pabender/HotBoxDetectorSimulator/images/IMGP5215.JPG

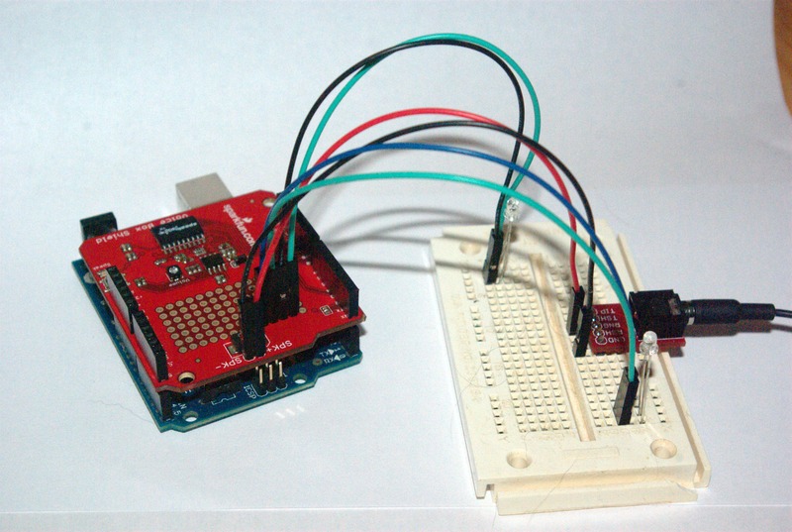
images/IMGP5215.JPG
