pabender/HotBoxDetectorSimulator/images/IMGP5261.JPG

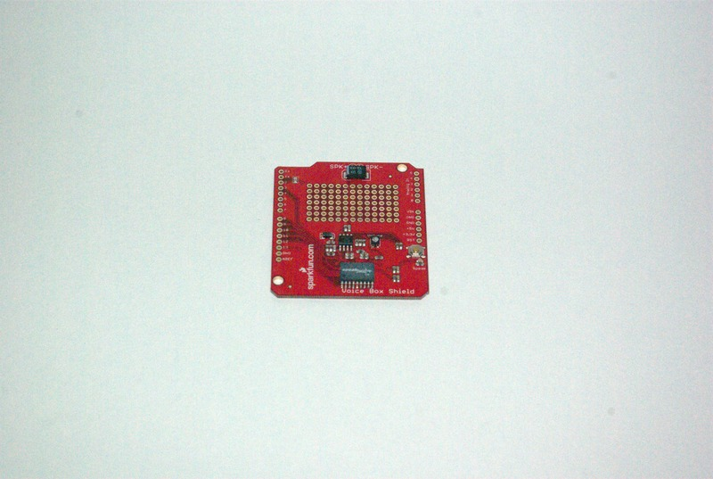
images/IMGP5261.JPG
