pabender/HotBoxDetectorSimulator/images/IMGP5262.JPG

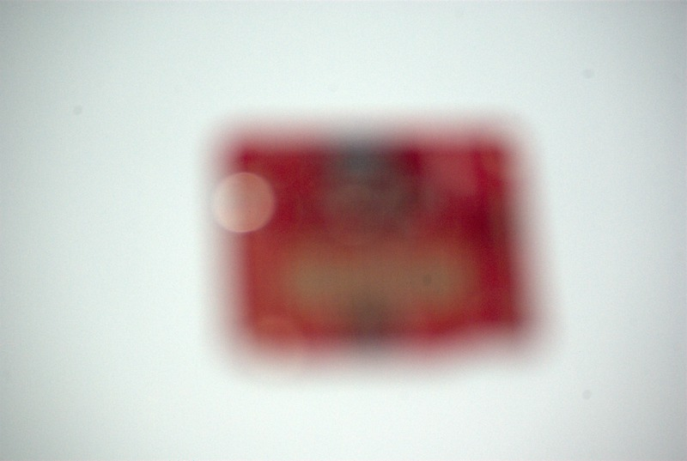
images/IMGP5262.JPG
