pabender/HotBoxDetectorSimulator/images/IMGP5263.JPG

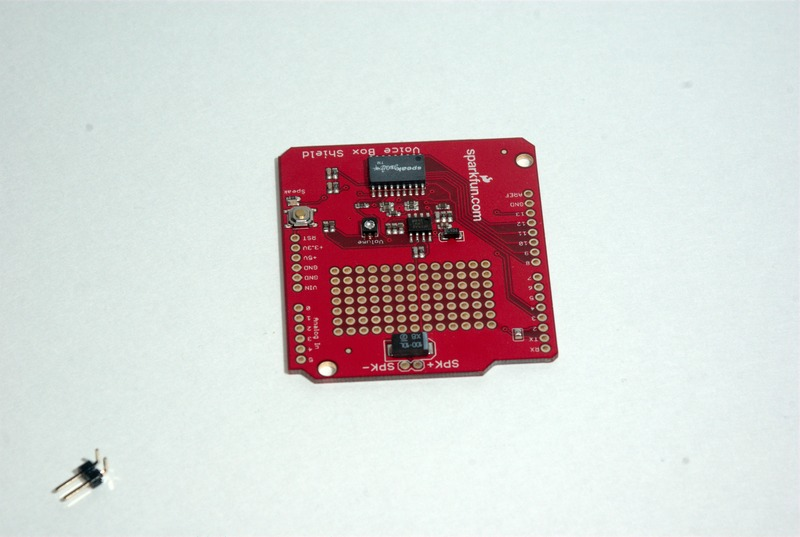
images/IMGP5263.JPG
