pabender/HotBoxDetectorSimulator/images/IMGP5265.JPG

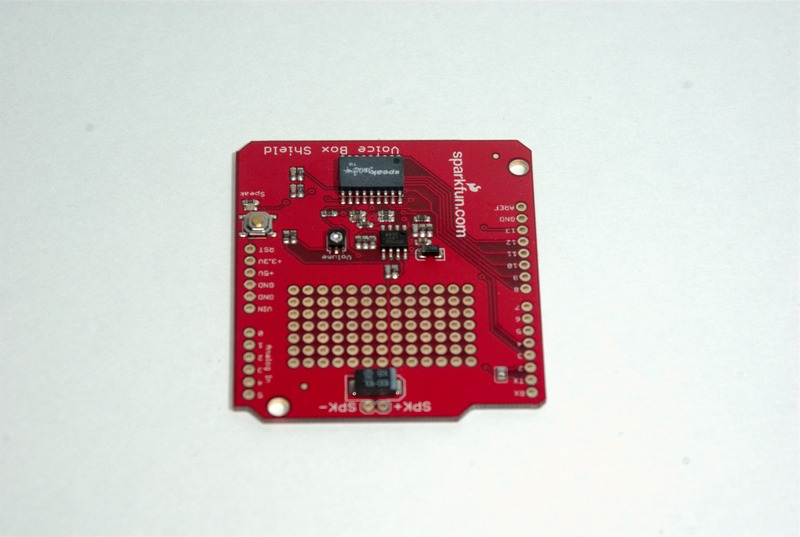
images/IMGP5265.JPG
