pabender/HotBoxDetectorSimulator/images/IMGP5266.JPG

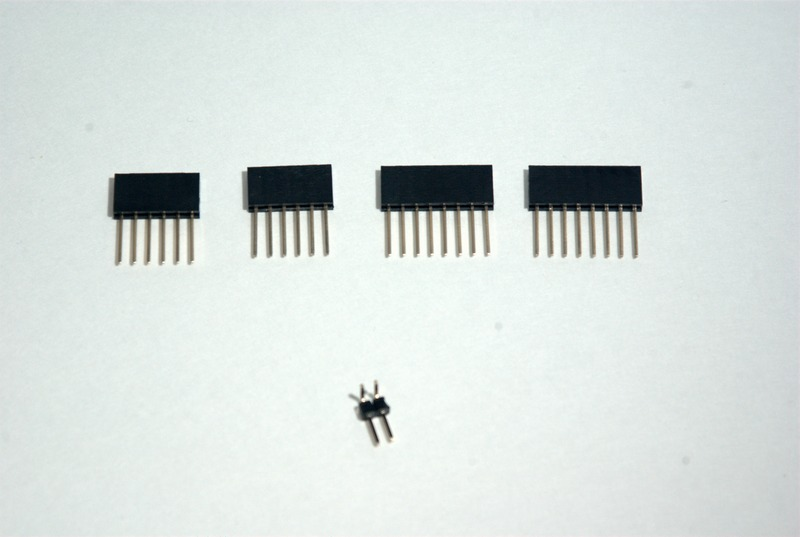
images/IMGP5266.JPG
