pabender/HotBoxDetectorSimulator/images/IMGP5267.JPG

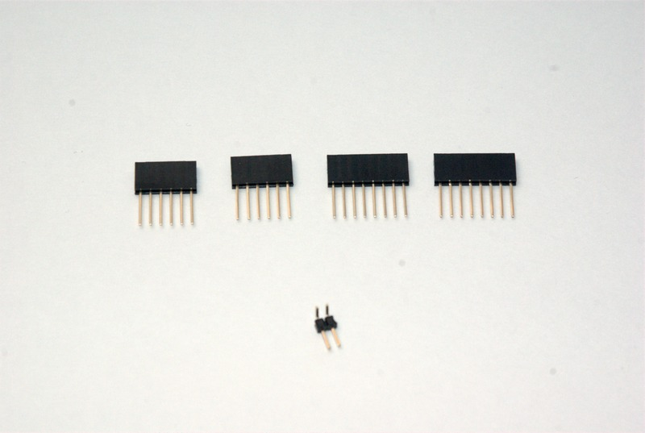
images/IMGP5267.JPG
