pabender/HotBoxDetectorSimulator/images/IMGP5269.JPG

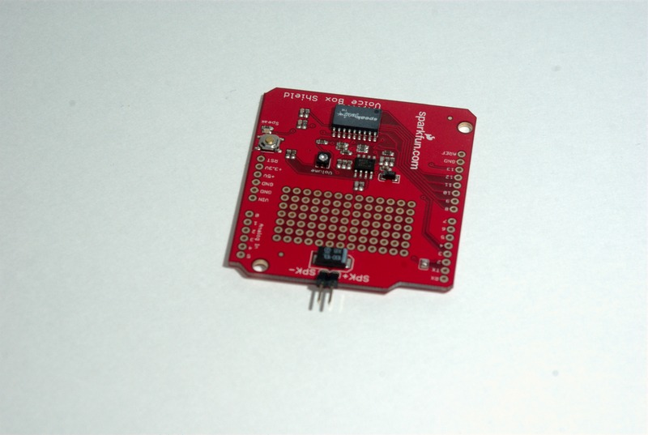
images/IMGP5269.JPG
