pabender/HotBoxDetectorSimulator/images/IMGP5270.JPG

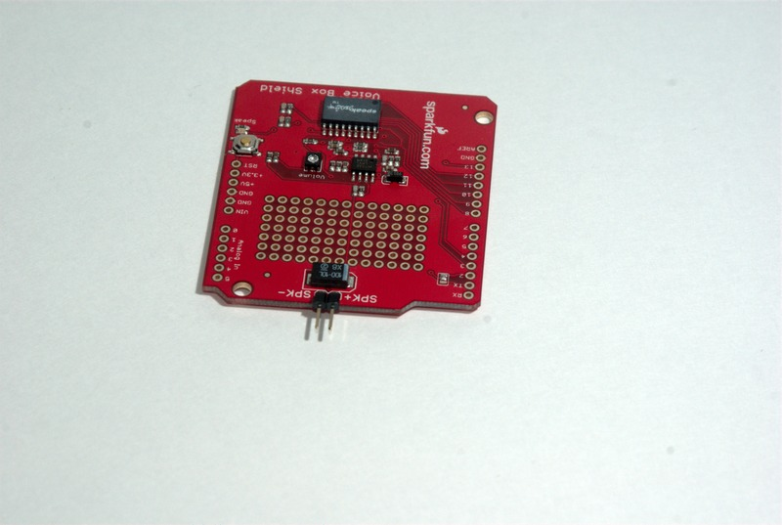
images/IMGP5270.JPG
