pabender/HotBoxDetectorSimulator/images/IMGP5272.JPG

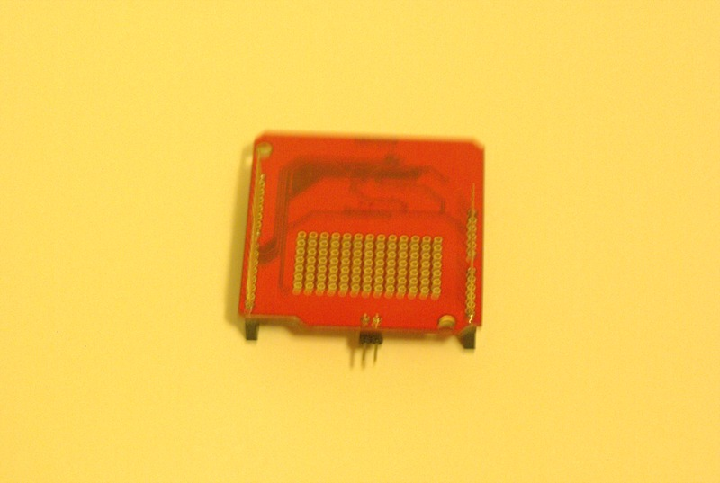
images/IMGP5272.JPG
