pabender/HotBoxDetectorSimulator/images/IMGP5277.JPG

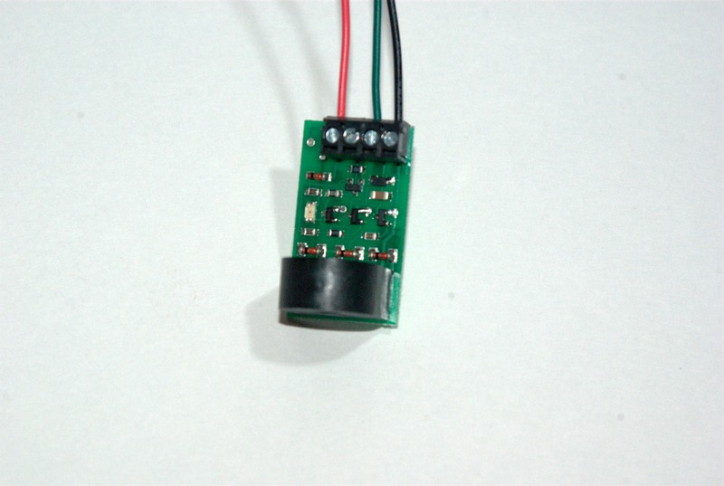
images/IMGP5277.JPG
