pabender/HotBoxDetectorSimulator/images/IMGP5278.JPG

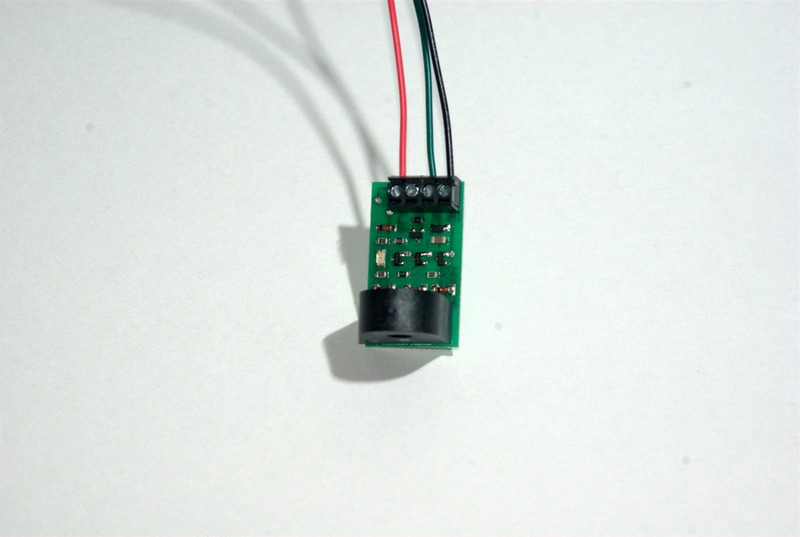
images/IMGP5278.JPG
