pabender/HotBoxDetectorSimulator/images/IMGP5279.JPG

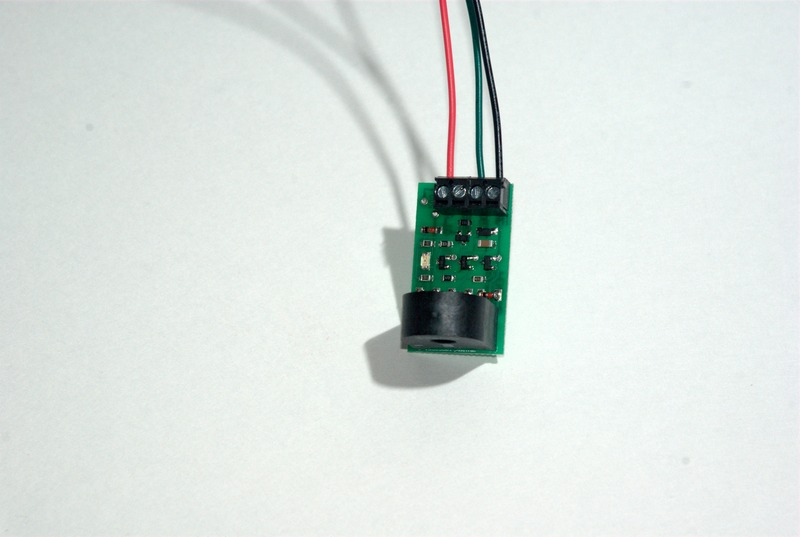
images/IMGP5279.JPG
