pabender/HotBoxDetectorSimulator/images/IMGP5280.JPG

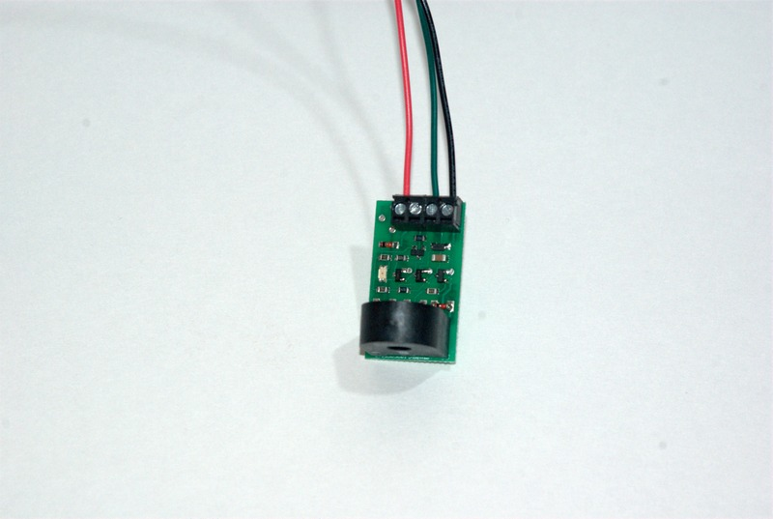
images/IMGP5280.JPG
