pabender/HotBoxDetectorSimulator/images/IMGP5281.JPG

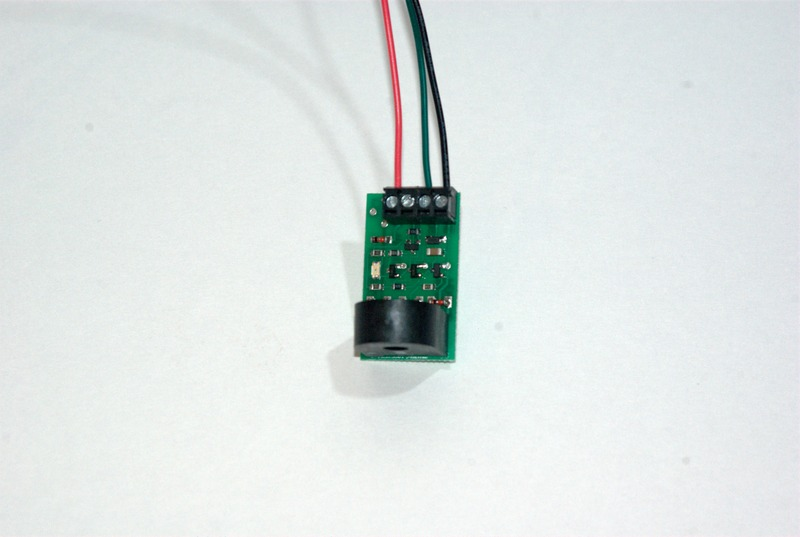
images/IMGP5281.JPG
