pabender/HotBoxDetectorSimulator/images/IMGP5282.JPG

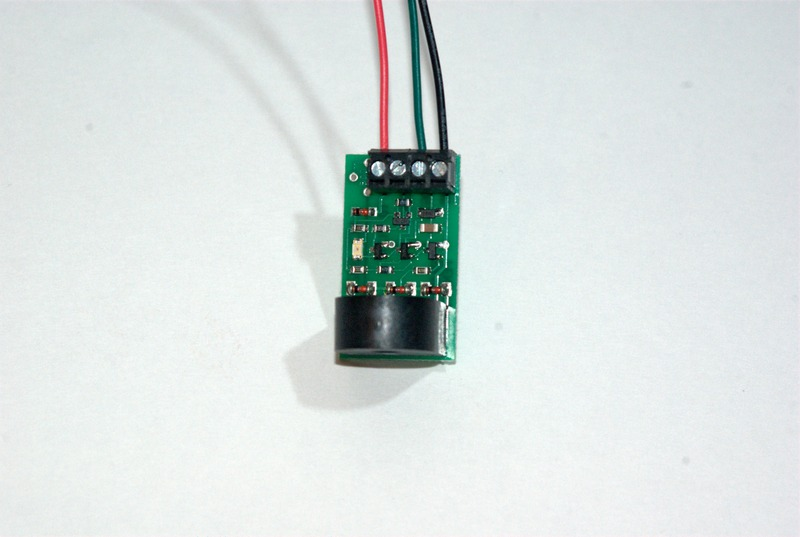
images/IMGP5282.JPG
