pabender/HotBoxDetectorSimulator/images/IMGP5283.JPG

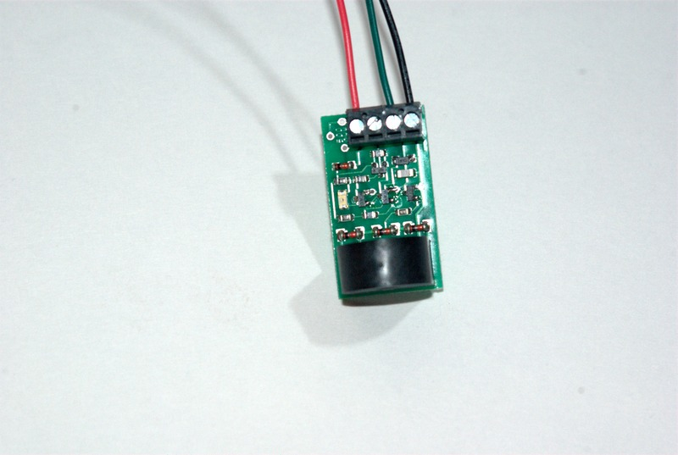
images/IMGP5283.JPG
