pabender/HotBoxDetectorSimulator/images/IMGP5285.JPG

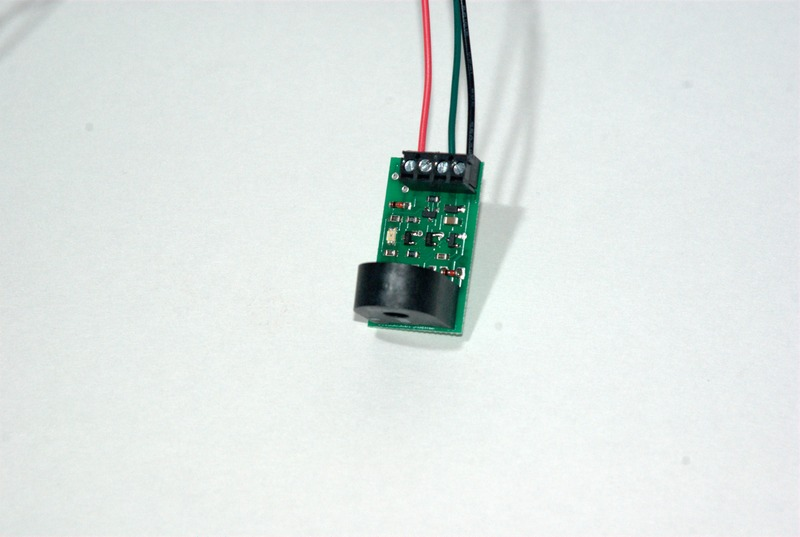
images/IMGP5285.JPG
