pabender/HotBoxDetectorSimulator/images/IMGP5287.JPG

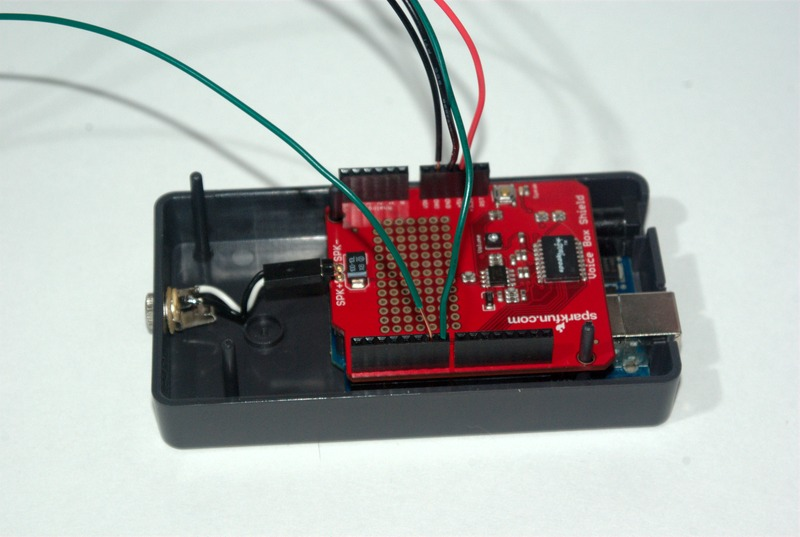
images/IMGP5287.JPG
