pabender/HotBoxDetectorSimulator/images/IMGP5290.JPG

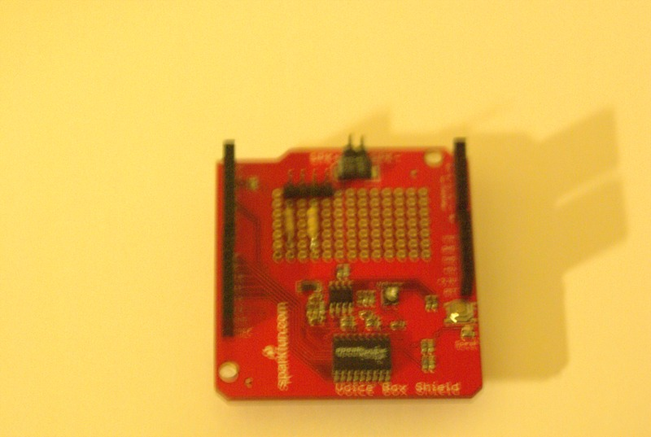
images/IMGP5290.JPG
