pabender/HotBoxDetectorSimulator/images/IMGP5291.JPG

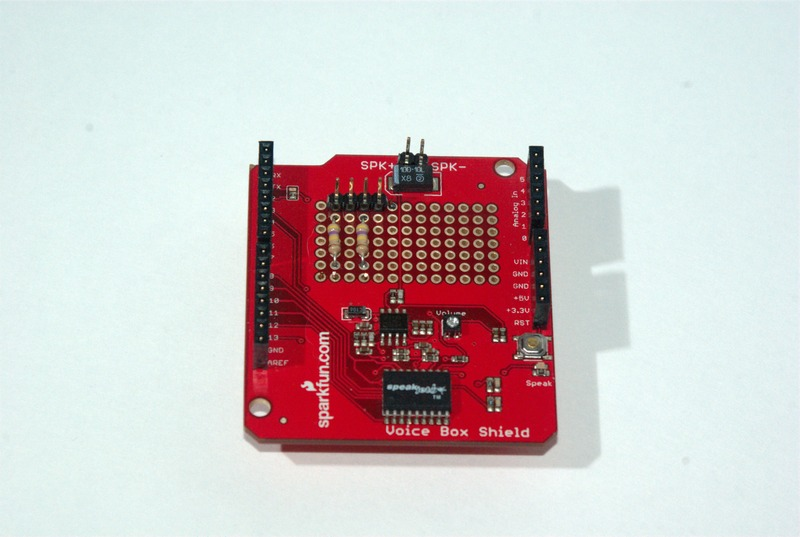
images/IMGP5291.JPG
