pabender/HotBoxDetectorSimulator/images/IMGP5292.JPG

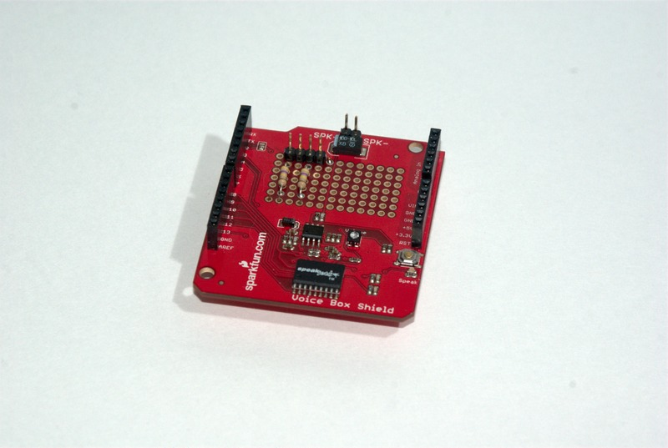
images/IMGP5292.JPG
