pabender/HotBoxDetectorSimulator/images/IMGP5295.JPG

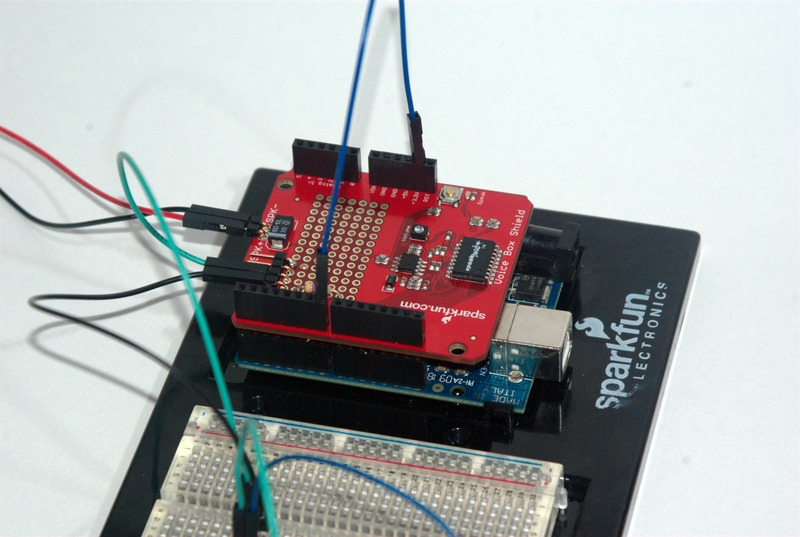
images/IMGP5295.JPG
