pabender/HotBoxDetectorSimulator/Numbers.h

// Define the SpeakJet Sequences for Numbers.
char ONE[]={20, VOLUME, 21, SPEED_SETTING, 22, PITCH_SETTING, 23, BEND_SETTING, 147, 14, 136, 8, 141,4,'\0'};
char TWO[]={20, VOLUME, 21, SPEED_SETTING, 22, PITCH_SETTING, 23, BEND_SETTING, 8, 191, 162,4,'\0'};
char THREE[]={20, VOLUME, 21, SPEED_SETTING, 22, PITCH_SETTING, 23, BEND_SETTING, 8, 190, 148, 8, 128,4,'\0'};
char FOUR[]={20, VOLUME, 21, SPEED_SETTING, 22, PITCH_SETTING, 23, BEND_SETTING, 186, 7, 137, 153,4,'\0'};
char FIVE[]={20, VOLUME, 21, SPEED_SETTING, 22, PITCH_SETTING, 23, BEND_SETTING,186,157,166,4,'\0'};
char SIX[]={20, VOLUME, 21, SPEED_SETTING, 22, PITCH_SETTING, 23, BEND_SETTING, 8,187,165,14,194,7,187,4,'\0'};
char SEVEN[]={20, VOLUME, 21, SPEED_SETTING, 22, PITCH_SETTING, 23, BEND_SETTING,8,187,7,131,166,131,141,4,'\0'};
char EIGHT[]={20, VOLUME, 21, SPEED_SETTING, 22, PITCH_SETTING, 23, BEND_SETTING,154,4,191,4,'\0'};
char NINE[]={20, VOLUME, 21, SPEED_SETTING, 22, PITCH_SETTING, 23, BEND_SETTING,142,14,157,142,130,4,'\0'};
char ZERO[]={20, VOLUME, 21, SPEED_SETTING, 22, PITCH_SETTING, 23, BEND_SETTING,167,7,128,7,149,164,4,'\0'};
char DOT[]={20, VOLUME, 21, SPEED_SETTING, 22, PITCH_SETTING, 23, BEND_SETTING, 175,7,135,191,4,'\0'};
