pabender/HotBoxDetectorSimulator/(commit log)

2022-08-29 add existing documentation
    [ArduinoPhototransistorInput-AcriveHigh.sch, ArduinoPhototransistorInput-ActiveLow.sch, ArduinoPhototransistorInput.sch]
2022-08-29 a couple of minor markdown formatting issues
2022-08-30 change name to match arduino convention
2023-12-02 some work on double track detection
2024-01-08 make it easy to disable the second track
2024-01-08 set to single track
2024-07-07 Add "Integrety Failure" message during start.
    [Audio.h, HotBoxDetectorSimulator.ino, Messages.h]
2024-07-07 Correctly report integrety failure while starting. Hold reports at start until after sensors are clear.
    [HotBoxDetectorSimulator.ino, Messages.h]
